useless-branch/eduSignalHW/board/board.kicad_pcb

## KiCad design board/board.kicad_pcb (2022-07-18)

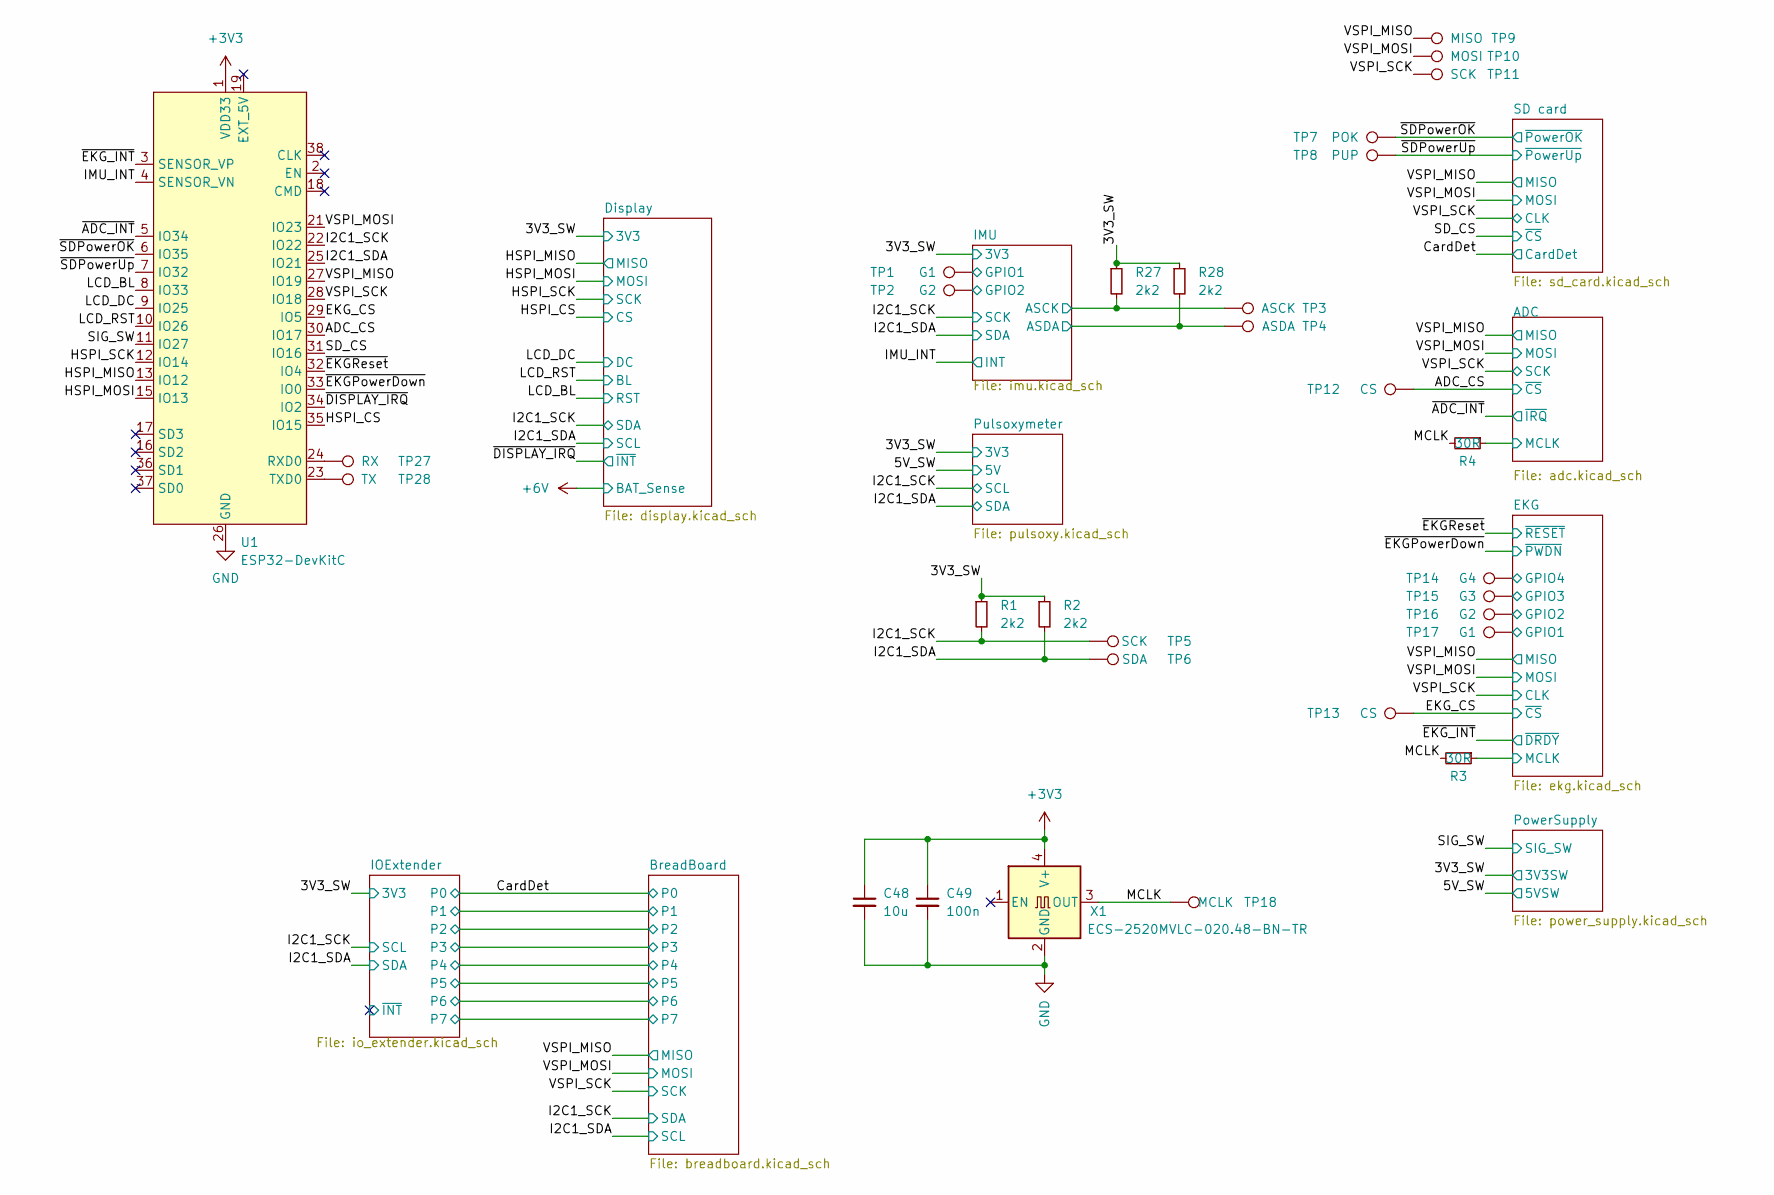
[picture p1: schematic board.kicad_sch, eduSignal]

Parts:
C48: 10u; C_0603_1608Metric
C49: 100n; C_0402_1005Metric
R1, R2, R27, R28: 2k2; R_0402_1005Metric
R3, R4: 30R; R_0402_1005Metric
TP1, TP17: G1; TestPoint_Pad_D1.0mm
TP2, TP16: G2; TestPoint_Pad_D1.0mm
TP3: ASCK; TestPoint_Pad_D1.0mm
TP4: ASDA; TestPoint_Pad_D1.0mm
TP5, TP11: SCK; TestPoint_Pad_D1.0mm
TP6: SDA; TestPoint_Pad_D1.0mm
TP7: POK; TestPoint_Pad_D1.0mm
TP8: PUP; TestPoint_Pad_D1.0mm
TP9: MISO; TestPoint_Pad_D1.0mm
TP10: MOSI; TestPoint_Pad_D1.0mm
TP12, TP13: CS; TestPoint_Pad_D1.0mm
TP14: G4; TestPoint_Pad_D1.0mm
TP15: G3; TestPoint_Pad_D1.0mm
TP18: MCLK; TestPoint_Pad_D1.0mm
TP27: RX; TestPoint_Pad_D1.0mm
TP28: TX; TestPoint_Pad_D1.0mm
U1: ESP32-DevKitC
X1: ECS-2520MVLC-020.48-BN-TR; Oscillator_SMD_EuroQuartz_XO32-4Pin_3.2x2.5mm

Connections:
+3V3: C48.1, C49.1, U1.1 (VDD33), X1.4 (V+); also elsewhere on the board
/3V3_SW: R1.1, R2.1, R27.1, R28.1; also elsewhere on the board
/ADC/MCLK: R4.1; also elsewhere on the board
/ADC_CS: TP12.1, U1.30 (IO17); also elsewhere on the board
/EKG/GPIO1: TP17.1; also elsewhere on the board
/EKG/GPIO2: TP16.1; also elsewhere on the board
/EKG/GPIO3: TP15.1; also elsewhere on the board
/EKG/GPIO4: TP14.1; also elsewhere on the board
/EKG/MCLK: R3.1; also elsewhere on the board
/EKG_CS: TP13.1, U1.29 (IO5); also elsewhere on the board
/HSPI_CS: U1.35 (IO15); also elsewhere on the board
/HSPI_MISO: U1.13 (IO12); also elsewhere on the board
/HSPI_MOSI: U1.15 (IO13); also elsewhere on the board
/HSPI_SCK: U1.12 (IO14); also elsewhere on the board
/I2C1_SCK: R1.2, TP5.1, U1.22 (IO22); also elsewhere on the board
/I2C1_SDA: R2.2, TP6.1, U1.25 (IO21); also elsewhere on the board
/IMU/ASCK: R27.2, TP3.1; also elsewhere on the board
/IMU/ASDA: R28.2, TP4.1; also elsewhere on the board
/IMU/GPIO1: TP1.1; also elsewhere on the board
/IMU/GPIO2: TP2.1; also elsewhere on the board
/IMU_INT: U1.4 (SENSOR_VN); also elsewhere on the board
/LCD_BL: U1.8 (IO33); also elsewhere on the board
/LCD_DC: U1.9 (IO25); also elsewhere on the board
/LCD_RST: U1.10 (IO26); also elsewhere on the board
/MCLK: R3.2, R4.2, TP18.1, X1.3 (OUT)
/SD_CS: U1.31 (IO16); also elsewhere on the board
/SIG_SW: U1.11 (IO27); also elsewhere on the board
/VSPI_MISO: TP9.1, U1.27 (IO19); also elsewhere on the board
/VSPI_MOSI: TP10.1, U1.21 (IO23); also elsewhere on the board
/VSPI_SCK: TP11.1, U1.28 (IO18); also elsewhere on the board
/~ADC_INT: U1.5 (IO34); also elsewhere on the board
/~DISPLAY_IRQ: U1.34 (IO2); also elsewhere on the board
/~EKGPowerDown: U1.33 (IO0); also elsewhere on the board
/~EKGReset: U1.32 (IO4); also elsewhere on the board
/~EKG_INT: U1.3 (SENSOR_VP); also elsewhere on the board
/~SDPowerOK: TP7.1, U1.6 (IO35); also elsewhere on the board
/~SDPowerUp: TP8.1, U1.7 (IO32); also elsewhere on the board
unnamed: TP27.1, U1.24 (RXD0)
unnamed: TP28.1, U1.23 (TXD0)

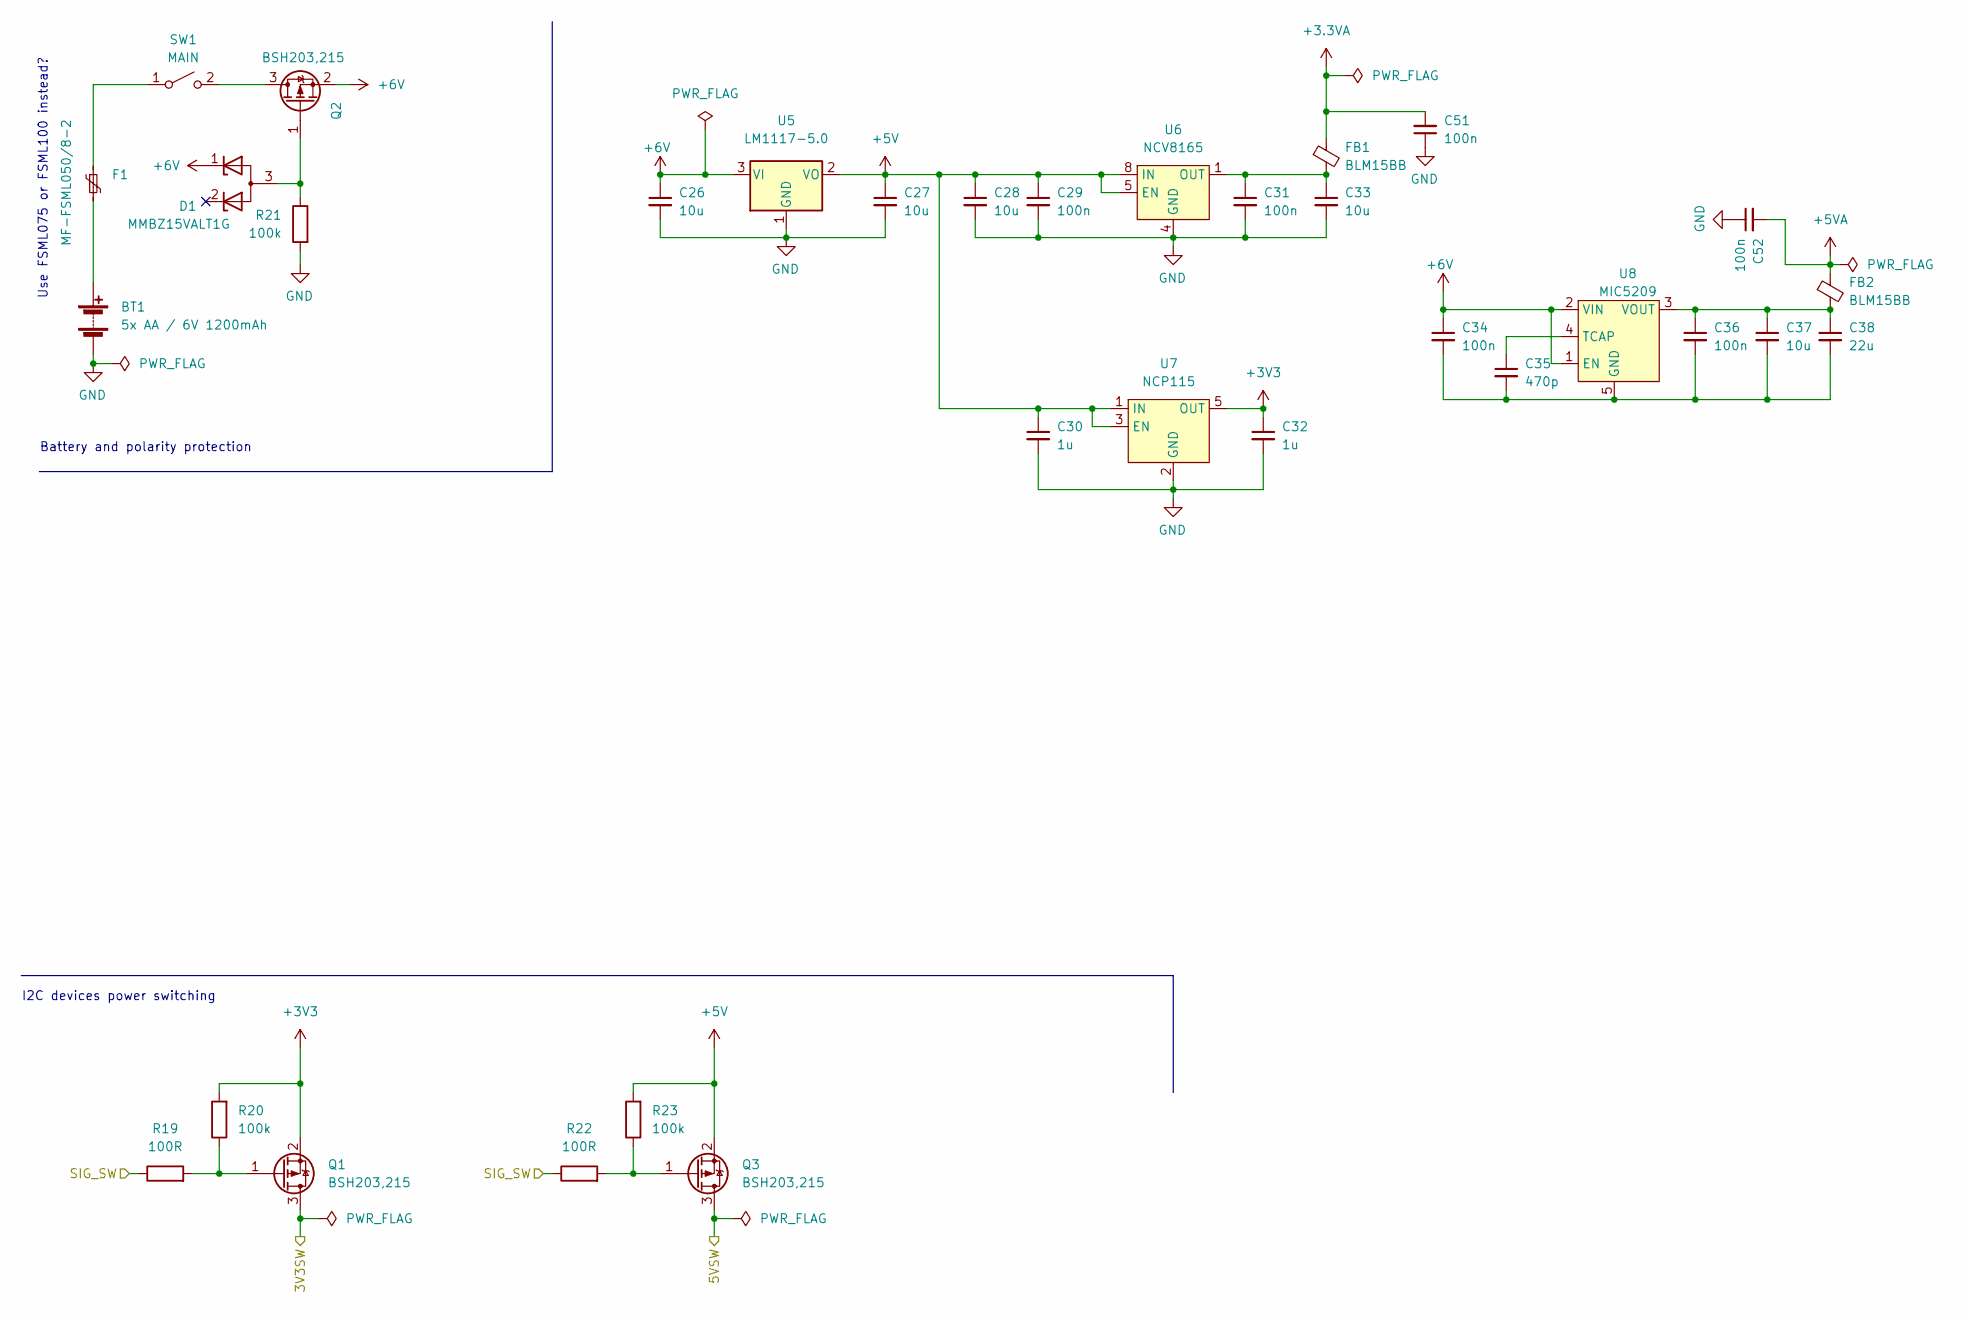
[picture p2: schematic power_supply.kicad_sch, eduSignal]

Parts:
BT1: 5x AA / 6V 1200mAh; PinHeader_1x02_P2.54mm_Vertical
C26, C27, C28, C33, C37: 10u; C_0603_1608Metric
C29, C31, C34, C36, C51, C52: 100n; C_0402_1005Metric
C30, C32: 1u; C_0603_1608Metric
C35: 470p; C_0402_1005Metric
C38: 22u; C_0805_2012Metric
D1: MMBZ15VALT1G; SOT-23; MOUSER_NO 863-SZMMBZ15VALT1G
F1: MF-FSML050/8-2; MF-FSML
FB1, FB2: BLM15BB; C_0402_1005Metric
Q1, Q3: BSH203,215; SOT-23; MOUSER_NO 78-SI2337DS-T1-BE3
Q2: BSH203,215; SOT-23; MOUSER_NO 771-BSH203215
R19, R22: 100R; R_0402_1005Metric; MOUSER_NO DO NOT ORDER
R20, R21, R23: 100k; R_0402_1005Metric; MOUSER_NO DO NOT ORDER
SW1: MAIN; PinHeader_1x02_P2.54mm_Vertical
U5: LM1117-5.0; SOT-223
U6: NCV8165; DFN-8-1EP_3x3mm_P0.65mm_EP1.7x2.05mm
U7: NCP115; TSOT-23-5
U8: MIC5209; SOICN-8LD

Connections:
+3.3VA: C51.2, FB1.1; also elsewhere on the board
+3V3: C32.1, Q1.2 (S), R20.2, U7.5 (OUT); also elsewhere on the board
+5V: C27.1, C28.1, C29.1, C30.1, Q3.2 (S), R23.2, U5.2 (VO), U5.4 (VO), U6.5 (EN), U6.8 (IN), U7.1 (IN), U7.3 (EN); also elsewhere on the board
+5VA: C52.2, FB2.1; also elsewhere on the board
+6V: C26.1, C34.1, D1.1 (K), Q2.2 (S), U5.3 (VI), U8.1 (EN), U8.2 (VIN); also elsewhere on the board
/3V3_SW: Q1.3 (D); also elsewhere on the board
/5V_SW: Q3.3 (D); also elsewhere on the board
/SIG_SW: R19.1, R22.1; also elsewhere on the board
unnamed: BT1.1 (+), F1.2
unnamed: C31.1, C33.1, FB1.2, U6.1 (OUT)
unnamed: C35.1, U8.4 (TCAP)
unnamed: C36.1, C37.1, C38.1, FB2.2, U8.3 (VOUT)
unnamed: D1.3 (A), Q2.1 (G), R21.1
unnamed: F1.1, SW1.1 (A)
unnamed: Q1.1 (G), R19.2, R20.1
unnamed: Q2.3 (D), SW1.2 (B)
unnamed: Q3.1 (G), R22.2, R23.1

Notes on the sheet:
I2C devices power switching
Battery and polarity protection
Use FSML075 or FSML100 instead?

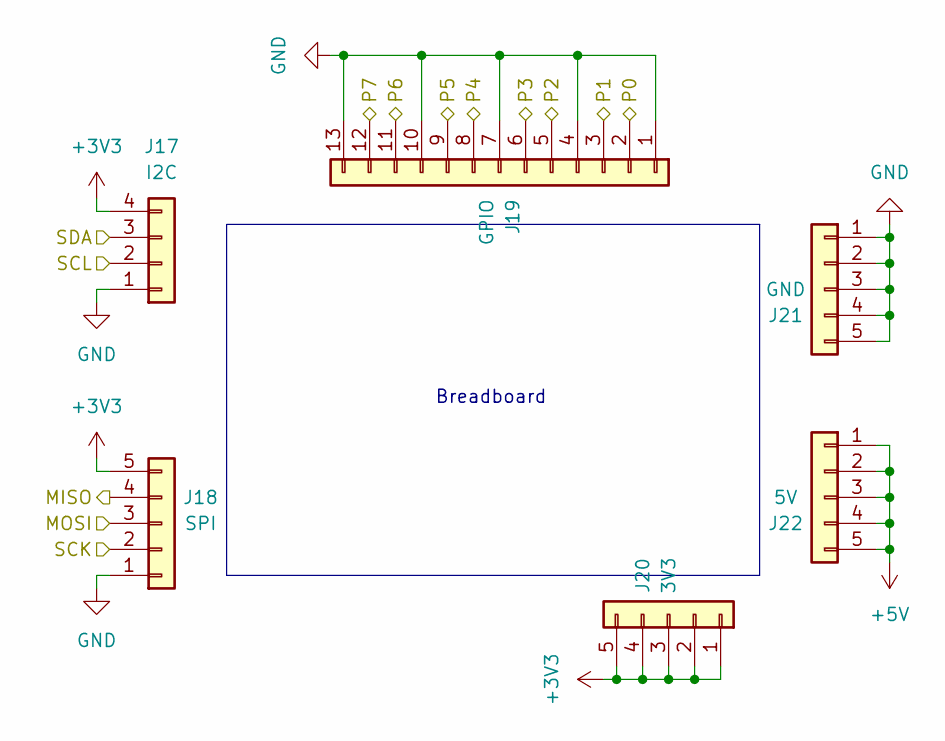
[picture p3: schematic breadboard.kicad_sch, eduSignal]

Parts:
J17: I2C; PinHeader_1x04_P2.54mm_Vertical
J18: SPI; PinHeader_1x05_P2.54mm_Vertical
J19: GPIO; PinHeader_1x13_P2.54mm_Vertical
J20: 3V3; PinHeader_1x05_P2.54mm_Vertical
J21: GND; PinHeader_1x05_P2.54mm_Vertical
J22: 5V; PinHeader_1x05_P2.54mm_Vertical

Connections:
+3V3: J17.4, J18.5, J20.1, J20.2, J20.3, J20.4, J20.5; also elsewhere on the board
+5V: J22.1, J22.2, J22.3, J22.4, J22.5; also elsewhere on the board
/BreadBoard/P1: J19.3; also elsewhere on the board
/BreadBoard/P2: J19.5; also elsewhere on the board
/BreadBoard/P3: J19.6; also elsewhere on the board
/BreadBoard/P4: J19.8; also elsewhere on the board
/BreadBoard/P5: J19.9; also elsewhere on the board
/BreadBoard/P6: J19.11; also elsewhere on the board
/BreadBoard/P7: J19.12; also elsewhere on the board
/CardDet: J19.2; also elsewhere on the board
/I2C1_SCK: J17.3; also elsewhere on the board
/I2C1_SDA: J17.2; also elsewhere on the board
/VSPI_MISO: J18.4; also elsewhere on the board
/VSPI_MOSI: J18.3; also elsewhere on the board
/VSPI_SCK: J18.2; also elsewhere on the board

Notes on the sheet:
Breadboard

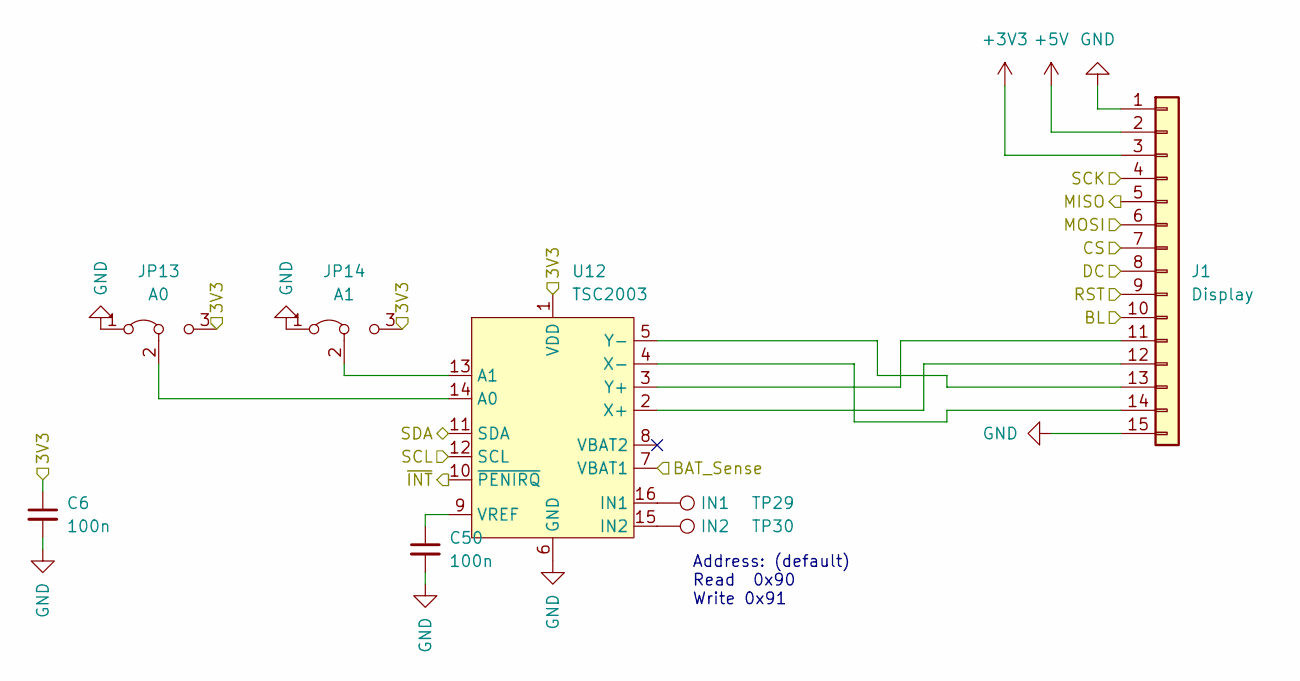
[picture p4: schematic display.kicad_sch, eduSignal]

Parts:
C6, C50: 100n; C_0402_1005Metric
J1: Display; PinHeader_1x15_P2.54mm_Vertical
JP13: A0; SolderJumper-3_P1.3mm_Bridged12_Pad1.0x1.5mm
JP14: A1; SolderJumper-3_P1.3mm_Bridged12_Pad1.0x1.5mm
TP29: IN1; TestPoint_Pad_D1.0mm
TP30: IN2; TestPoint_Pad_D1.0mm
U12: TSC2003; TSSOP-16_4.4x5mm_P0.65mm_EP3x3mm

Connections:
+3V3: J1.3; also elsewhere on the board
+5V: J1.2; also elsewhere on the board
+6V: U12.7 (VBAT1); also elsewhere on the board
/3V3_SW: C6.1, JP13.3 (B), JP14.3 (B), U12.1 (VDD); also elsewhere on the board
/HSPI_CS: J1.7; also elsewhere on the board
/HSPI_MISO: J1.5; also elsewhere on the board
/HSPI_MOSI: J1.6; also elsewhere on the board
/HSPI_SCK: J1.4; also elsewhere on the board
/I2C1_SCK: U12.11 (SDA); also elsewhere on the board
/I2C1_SDA: U12.12 (SCL); also elsewhere on the board
/LCD_BL: J1.9; also elsewhere on the board
/LCD_DC: J1.8; also elsewhere on the board
/LCD_RST: J1.10; also elsewhere on the board
/~DISPLAY_IRQ: U12.10 (~PENIRQ); also elsewhere on the board
unnamed: C50.1, U12.9 (VREF)
unnamed: J1.11, U12.3 (Y+)
unnamed: J1.12, U12.2 (X+)
unnamed: J1.13, U12.5 (Y-)
unnamed: J1.14, U12.4 (X-)
unnamed: JP13.2 (C), U12.14 (A0)
unnamed: JP14.2 (C), U12.13 (A1)
unnamed: TP29.1, U12.16 (IN1)
unnamed: TP30.1, U12.15 (IN2)

Notes on the sheet:
Address: (default) Read 0x90 Write 0x91

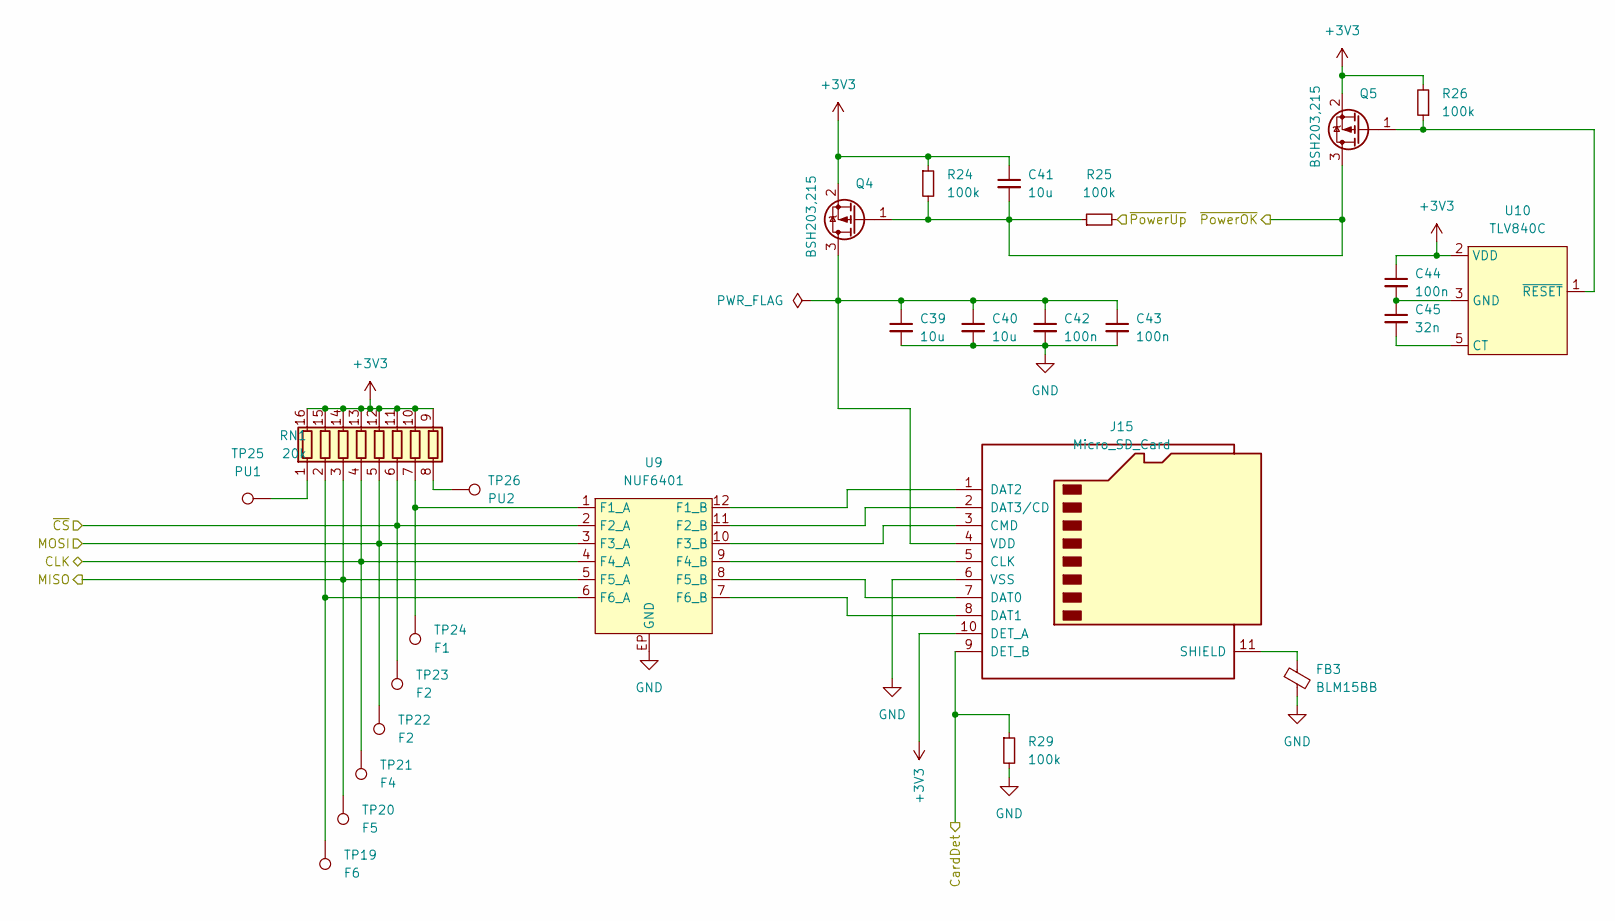
[picture p5: schematic sd_card.kicad_sch, eduSignal]

Parts:
C39, C40, C41: 10u; C_0603_1608Metric
C42, C43, C44: 100n; C_0402_1005Metric
C45: 32n; C_0402_1005Metric
FB3: BLM15BB; C_0402_1005Metric
J15: Micro_SD_Card; GCT MEM2061
Q4, Q5: BSH203,215; SOT-23; MOUSER_NO 771-BSH203215
R24, R25, R26, R29: 100k; R_0402_1005Metric
RN1: 20k; R_Array_Convex_8x0602
TP19: F6; TestPoint_Pad_D1.0mm
TP20: F5; TestPoint_Pad_D1.0mm
TP21: F4; TestPoint_Pad_D1.0mm
TP22, TP23: F2; TestPoint_Pad_D1.0mm
TP24: F1; TestPoint_Pad_D1.0mm
TP25: PU1; TestPoint_Pad_D1.0mm
TP26: PU2; TestPoint_Pad_D1.0mm
U9: NUF6401
U10: TLV840C; SOT-23-5

Connections:
+3V3: C41.1, C44.1, J15.10 (DET_A), Q4.2 (S), Q5.2 (S), R24.1, R26.2, RN1.9 (R8.2), RN1.10 (R7.2), RN1.11 (R6.2), RN1.12 (R5.2), RN1.13 (R4.2), RN1.14 (R3.2), RN1.15 (R2.2), RN1.16 (R1.2), U10.2 (VDD); also elsewhere on the board
/CardDet: J15.9 (DET_B), R29.1; also elsewhere on the board
/SD_CS: RN1.6 (R6.1), TP23.1, U9.2 (F2_A); also elsewhere on the board
/VSPI_MISO: RN1.3 (R3.1), TP20.1, U9.5 (F5_A); also elsewhere on the board
/VSPI_MOSI: RN1.5 (R5.1), TP22.1, U9.3 (F3_A); also elsewhere on the board
/VSPI_SCK: RN1.4 (R4.1), TP21.1, U9.4 (F4_A); also elsewhere on the board
/~SDPowerOK: C41.2, Q4.1 (G), Q5.3 (D), R24.2, R25.1; also elsewhere on the board
/~SDPowerUp: R25.2; also elsewhere on the board
unnamed: C39.1, C40.1, C42.1, C43.1, J15.4 (VDD), Q4.3 (D)
unnamed: C44.2, C45.1, U10.3 (GND)
unnamed: C45.2, U10.5 (CT)
unnamed: FB3.1, J15.11 (SHIELD)
unnamed: J15.1 (DAT2), U9.12 (F1_B)
unnamed: J15.2 (DAT3/CD), U9.11 (F2_B)
unnamed: J15.3 (CMD), U9.10 (F3_B)
unnamed: J15.5 (CLK), U9.9 (F4_B)
unnamed: J15.7 (DAT0), U9.8 (F5_B)
unnamed: J15.8 (DAT1), U9.7 (F6_B)
unnamed: Q5.1 (G), R26.1, U10.1 (~RESET)
unnamed: RN1.1 (R1.1), TP25.1
unnamed: RN1.2 (R2.1), TP19.1, U9.6 (F6_A)
unnamed: RN1.7 (R7.1), TP24.1, U9.1 (F1_A)
unnamed: RN1.8 (R8.1), TP26.1

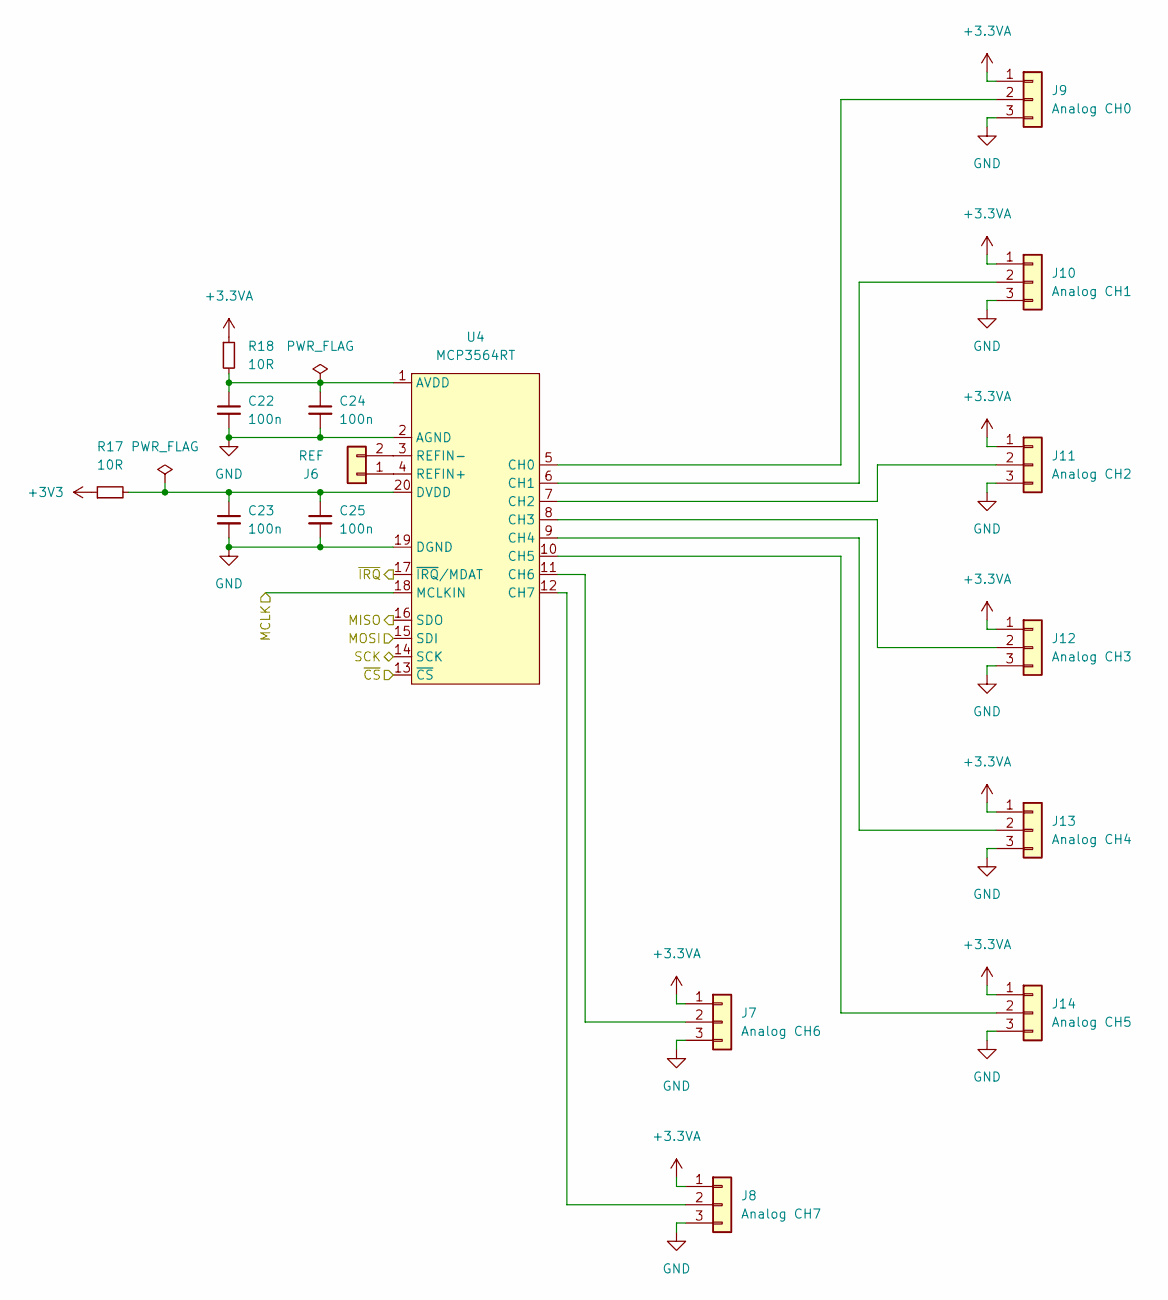
[picture p6: schematic adc.kicad_sch, eduSignal]

Parts:
C22, C23, C24, C25: 100n; C_0402_1005Metric
J6: REF; PinHeader_1x02_P2.54mm_Vertical
J7: Analog CH6; PinHeader_1x03_P2.54mm_Vertical
J8: Analog CH7; PinHeader_1x03_P2.54mm_Vertical
J9: Analog CH0; PinHeader_1x03_P2.54mm_Vertical
J10: Analog CH1; PinHeader_1x03_P2.54mm_Vertical
J11: Analog CH2; PinHeader_1x03_P2.54mm_Vertical
J12: Analog CH3; PinHeader_1x03_P2.54mm_Vertical
J13: Analog CH4; PinHeader_1x03_P2.54mm_Vertical
J14: Analog CH5; PinHeader_1x03_P2.54mm_Vertical
R17, R18: 10R; R_0402_1005Metric
U4: MCP3564RT; HTSSOP-20-1EP_4.4x6.5mm_P0.65mm_3.4x6.5mm_Mask2.75x3.43mm

Connections:
+3.3VA: J7.1, J8.1, J9.1, J10.1, J11.1, J12.1, J13.1, J14.1, R18.1; also elsewhere on the board
+3V3: R17.1; also elsewhere on the board
/ADC/MCLK: U4.18 (MCLKIN); also elsewhere on the board
/ADC_CS: U4.13 (~CS); also elsewhere on the board
/VSPI_MISO: U4.16 (SDO); also elsewhere on the board
/VSPI_MOSI: U4.15 (SDI); also elsewhere on the board
/VSPI_SCK: U4.14 (SCK); also elsewhere on the board
/~ADC_INT: U4.17 (~IRQ/MDAT); also elsewhere on the board
unnamed: C22.1, C24.1, R18.2, U4.1 (AVDD)
unnamed: C23.1, C25.1, R17.2, U4.20 (DVDD)
unnamed: J6.1, U4.4 (REFIN+)
unnamed: J6.2, U4.3 (REFIN-)
unnamed: J7.2, U4.11 (CH6)
unnamed: J8.2, U4.12 (CH7)
unnamed: J9.2, U4.5 (CH0)
unnamed: J10.2, U4.6 (CH1)
unnamed: J11.2, U4.7 (CH2)
unnamed: J12.2, U4.8 (CH3)
unnamed: J13.2, U4.9 (CH4)
unnamed: J14.2, U4.10 (CH5)

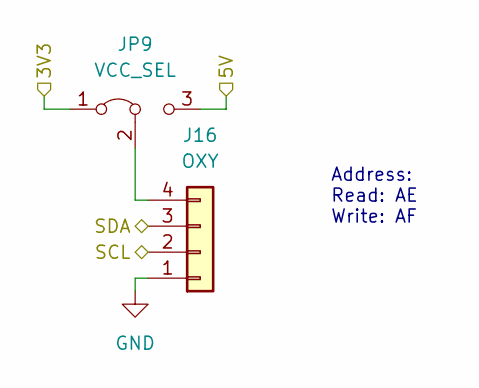
[picture p7: schematic pulsoxy.kicad_sch, eduSignal]

Parts:
J16: OXY; PinHeader_1x04_P2.54mm_Vertical
JP9: VCC_SEL; SolderJumper-3_P1.3mm_Bridged12_Pad1.0x1.5mm

Connections:
/3V3_SW: JP9.1 (A); also elsewhere on the board
/5V_SW: JP9.3 (B); also elsewhere on the board
/I2C1_SCK: J16.2; also elsewhere on the board
/I2C1_SDA: J16.3; also elsewhere on the board
unnamed: J16.4, JP9.2 (C)

Notes on the sheet:
Address: Read: AE Write: AF

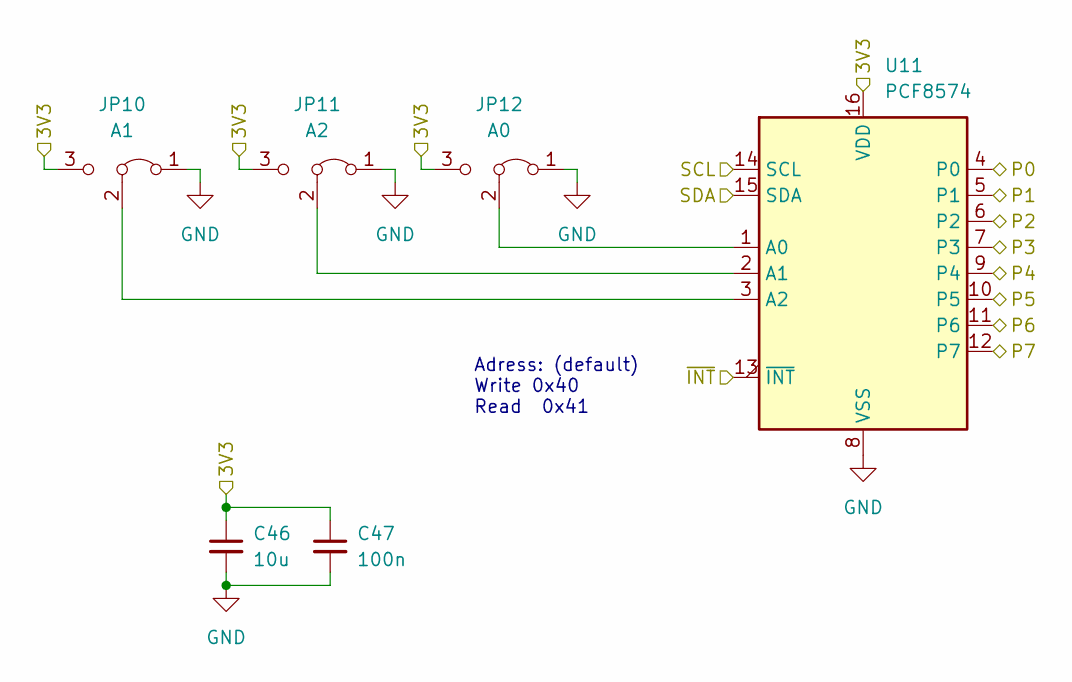
[picture p8: schematic io_extender.kicad_sch, eduSignal]

Parts:
C46: 10u; C_0603_1608Metric
C47: 100n; C_0402_1005Metric
JP10: A1; SolderJumper-3_P1.3mm_Bridged12_Pad1.0x1.5mm
JP11: A2; SolderJumper-3_P1.3mm_Bridged12_Pad1.0x1.5mm
JP12: A0; SolderJumper-3_P1.3mm_Bridged12_Pad1.0x1.5mm
U11: PCF8574; SOIC-16W_7.5x10.3mm_P1.27mm

Connections:
/3V3_SW: C46.1, C47.1, JP10.3 (B), JP11.3 (B), JP12.3 (B), U11.16 (VDD); also elsewhere on the board
/BreadBoard/P1: U11.5 (P1); also elsewhere on the board
/BreadBoard/P2: U11.6 (P2); also elsewhere on the board
/BreadBoard/P3: U11.7 (P3); also elsewhere on the board
/BreadBoard/P4: U11.9 (P4); also elsewhere on the board
/BreadBoard/P5: U11.10 (P5); also elsewhere on the board
/BreadBoard/P6: U11.11 (P6); also elsewhere on the board
/BreadBoard/P7: U11.12 (P7); also elsewhere on the board
/CardDet: U11.4 (P0); also elsewhere on the board
/I2C1_SCK: U11.14 (SCL); also elsewhere on the board
/I2C1_SDA: U11.15 (SDA); also elsewhere on the board
/IOExtender/~INT: U11.13 (~INT)
unnamed: JP10.2 (C), U11.3 (A2)
unnamed: JP11.2 (C), U11.2 (A1)
unnamed: JP12.2 (C), U11.1 (A0)

Notes on the sheet:
Adress: (default) Write 0x40 Read 0x41

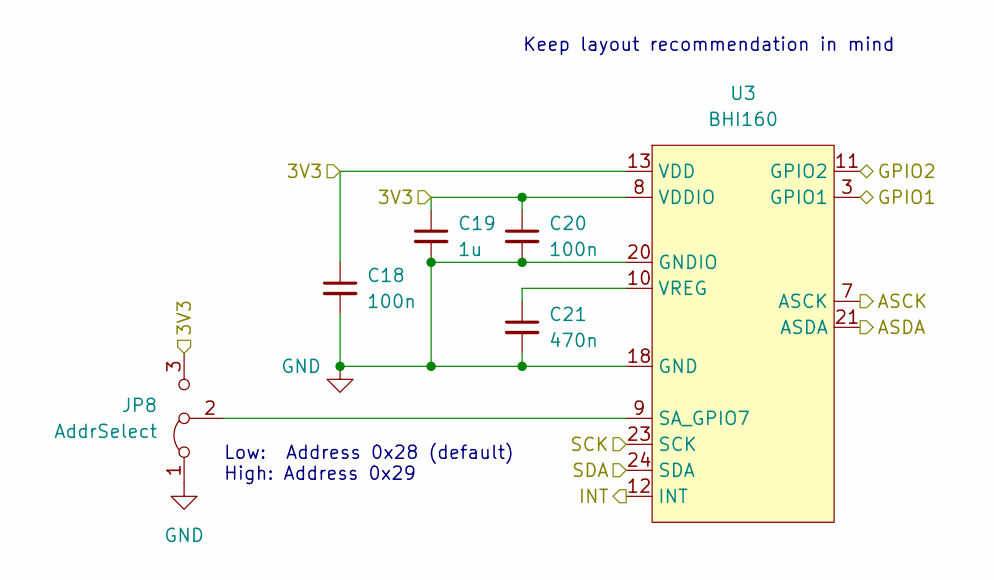
[picture p9: schematic imu.kicad_sch, eduSignal]

Parts:
C18, C20: 100n; C_0402_1005Metric
C19: 1u; C_0603_1608Metric
C21: 470n; C_0402_1005Metric
JP8: AddrSelect; SolderJumper-3_P1.3mm_Bridged12_Pad1.0x1.5mm
U3: BHI160

Connections:
/3V3_SW: C18.1, C19.1, C20.1, JP8.3 (B), U3.8 (VDDIO), U3.13 (VDD); also elsewhere on the board
/I2C1_SCK: U3.23 (SCK); also elsewhere on the board
/I2C1_SDA: U3.24 (SDA); also elsewhere on the board
/IMU/ASCK: U3.7 (ASCK); also elsewhere on the board
/IMU/ASDA: U3.21 (ASDA); also elsewhere on the board
/IMU/GPIO1: U3.3 (GPIO1); also elsewhere on the board
/IMU/GPIO2: U3.11 (GPIO2); also elsewhere on the board
/IMU_INT: U3.12 (INT); also elsewhere on the board
unnamed: C21.1, U3.10 (VREG)
unnamed: JP8.2 (C), U3.9 (SA_GPIO7)

Notes on the sheet:
Keep layout recommendation in mind
Low: Address 0x28 (default) High: Address 0x29

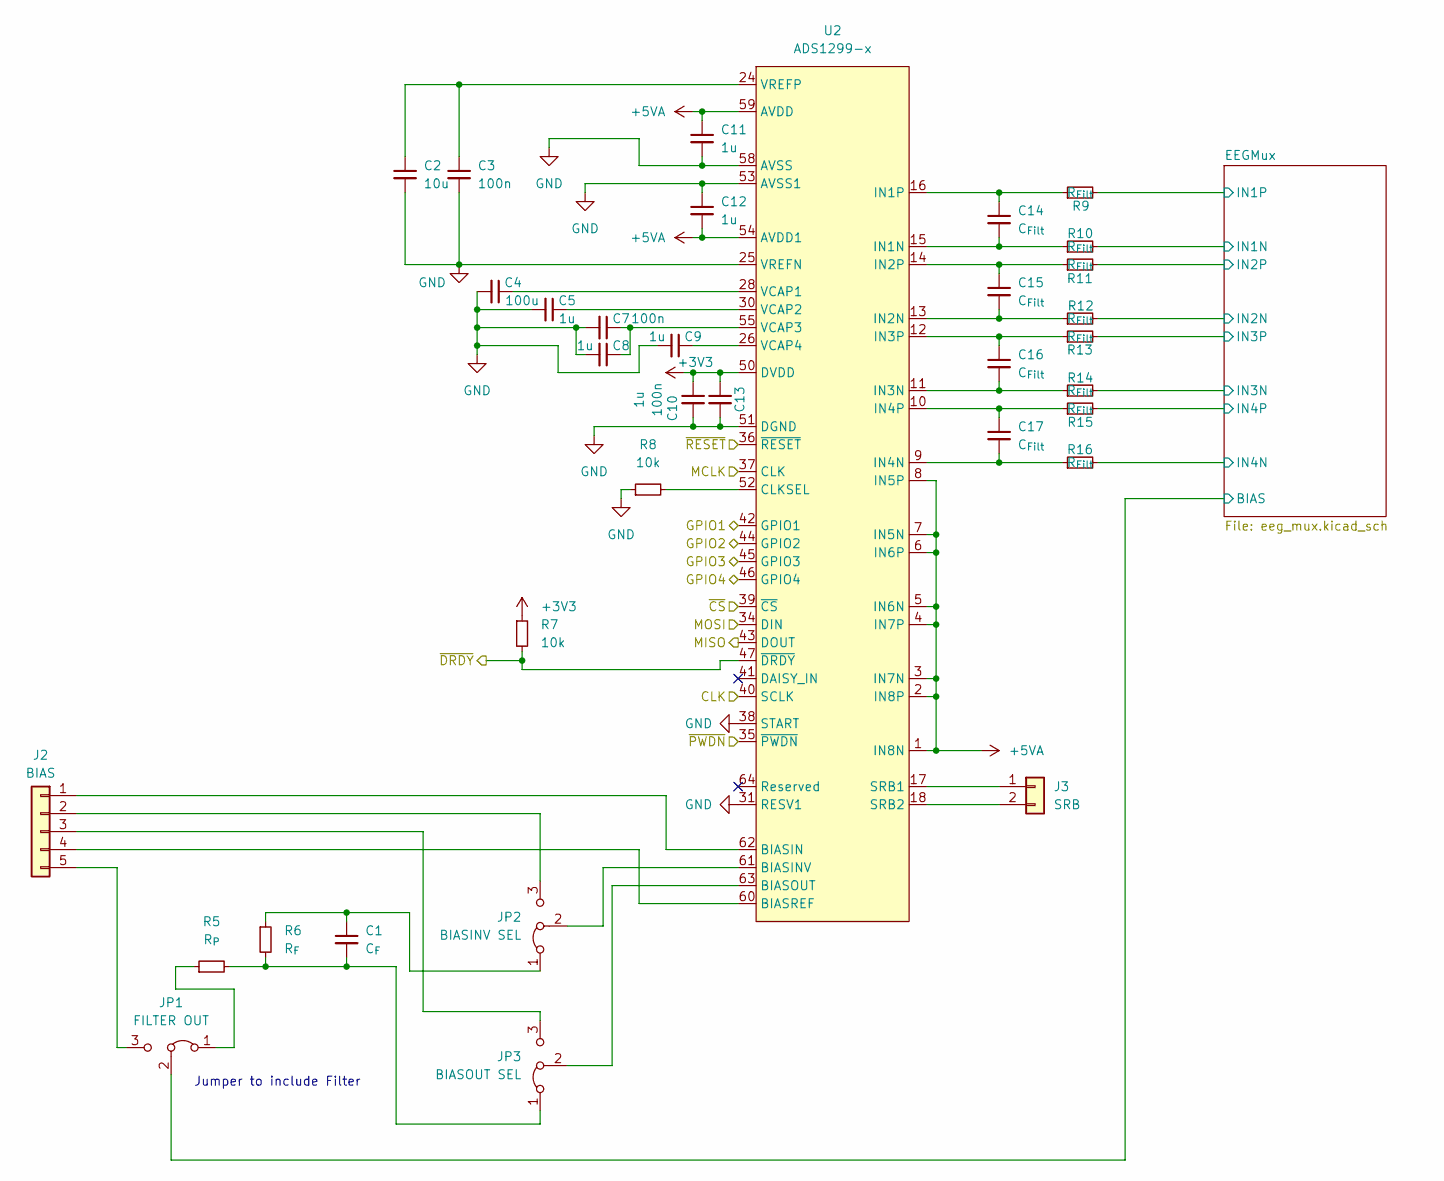
[picture p10: schematic ekg.kicad_sch, eduSignal]

Parts:
C1: C_{F}; C_0603_1608Metric_Pad1.08x0.95mm_HandSolder
C2: 10u; C_0603_1608Metric
C3, C7, C13: 100n; C_0402_1005Metric
C4: 100u; C_1206_3216Metric
C5, C8, C9, C10, C11, C12: 1u; C_0603_1608Metric
C14, C15, C16, C17: C_{Filt}; C_0603_1608Metric_Pad1.08x0.95mm_HandSolder
J2: BIAS; PinHeader_1x05_P2.54mm_Vertical
J3: SRB; PinHeader_1x02_P2.54mm_Vertical
JP1: FILTER OUT; PinHeader_1x03_P2.54mm_Vertical
JP2: BIASINV SEL; PinHeader_1x03_P2.54mm_Vertical
JP3: BIASOUT SEL; PinHeader_1x03_P2.54mm_Vertical
R5: R_{P}; R_0603_1608Metric_Pad0.98x0.95mm_HandSolder
R6: R_{F}; R_0603_1608Metric_Pad0.98x0.95mm_HandSolder
R7, R8: 10k; R_0402_1005Metric
R9, R10, R11, R12, R13, R14, R15, R16: R_{Filt}; R_0603_1608Metric_Pad0.98x0.95mm_HandSolder
U2: ADS1299-x; TQFP-64_10x10mm_P0.5mm

Connections:
+3V3: C10.1, C13.1, R7.1, U2.48 (DVDD), U2.50 (DVDD); also elsewhere on the board
+5VA: C11.1, C12.2, U2.1 (IN8N), U2.2 (IN8P), U2.3 (IN7N), U2.4 (IN7P), U2.5 (IN6N), U2.6 (IN6P), U2.7 (IN5N), U2.8 (IN5P), U2.19 (AVDD), U2.21 (AVDD), U2.22 (AVDD), U2.54 (AVDD1), U2.56 (AVDD), U2.59 (AVDD); also elsewhere on the board
/EKG/EEGMux/BIAS: JP1.2 (C); also elsewhere on the board
/EKG/EEGMux/IN1N: R10.2; also elsewhere on the board
/EKG/EEGMux/IN1P: R9.2; also elsewhere on the board
/EKG/EEGMux/IN2N: R12.2; also elsewhere on the board
/EKG/EEGMux/IN2P: R11.2; also elsewhere on the board
/EKG/EEGMux/IN3N: R14.2; also elsewhere on the board
/EKG/EEGMux/IN3P: R13.2; also elsewhere on the board
/EKG/EEGMux/IN4N: R16.2; also elsewhere on the board
/EKG/EEGMux/IN4P: R15.2; also elsewhere on the board
/EKG/GPIO1: U2.42 (GPIO1); also elsewhere on the board
/EKG/GPIO2: U2.44 (GPIO2); also elsewhere on the board
/EKG/GPIO3: U2.45 (GPIO3); also elsewhere on the board
/EKG/GPIO4: U2.46 (GPIO4); also elsewhere on the board
/EKG/MCLK: U2.37 (CLK); also elsewhere on the board
/EKG_CS: U2.39 (~CS); also elsewhere on the board
/VSPI_MISO: U2.43 (DOUT); also elsewhere on the board
/VSPI_MOSI: U2.34 (DIN); also elsewhere on the board
/VSPI_SCK: U2.40 (SCLK); also elsewhere on the board
/~EKGPowerDown: U2.35 (~PWDN); also elsewhere on the board
/~EKGReset: U2.36 (~RESET); also elsewhere on the board
/~EKG_INT: R7.2, U2.47 (~DRDY); also elsewhere on the board
unnamed: C1.1, JP2.1 (A), R6.1
unnamed: C1.2, JP3.1 (A), R5.2, R6.2
unnamed: C2.1, C3.1, U2.24 (VREFP)
unnamed: C4.1, U2.28 (VCAP1)
unnamed: C5.1, U2.30 (VCAP2)
unnamed: C7.1, C8.1, U2.55 (VCAP3)
unnamed: C9.1, U2.26 (VCAP4)
unnamed: C14.1, R9.1, U2.16 (IN1P)
unnamed: C14.2, R10.1, U2.15 (IN1N)
unnamed: C15.1, R11.1, U2.14 (IN2P)
unnamed: C15.2, R12.1, U2.13 (IN2N)
unnamed: C16.1, R13.1, U2.12 (IN3P)
unnamed: C16.2, R14.1, U2.11 (IN3N)
unnamed: C17.1, R15.1, U2.10 (IN4P)
unnamed: C17.2, R16.1, U2.9 (IN4N)
unnamed: J2.1, U2.62 (BIASIN)
unnamed: J2.2, JP2.3 (B)
unnamed: J2.3, JP3.3 (B)
unnamed: J2.4, U2.60 (BIASREF)
unnamed: J2.5, JP1.3 (B)
unnamed: J3.1, U2.17 (SRB1)
unnamed: J3.2, U2.18 (SRB2)
unnamed: JP1.1 (A), R5.1
unnamed: JP2.2 (C), U2.61 (BIASINV)
unnamed: JP3.2 (C), U2.63 (BIASOUT)
unnamed: R8.2, U2.52 (CLKSEL)

Notes on the sheet:
Jumper to include Filter
