useless-branch/eduSignalHW/board/board.kicad_pcb

## KiCad design board/board.kicad_pcb (continued)

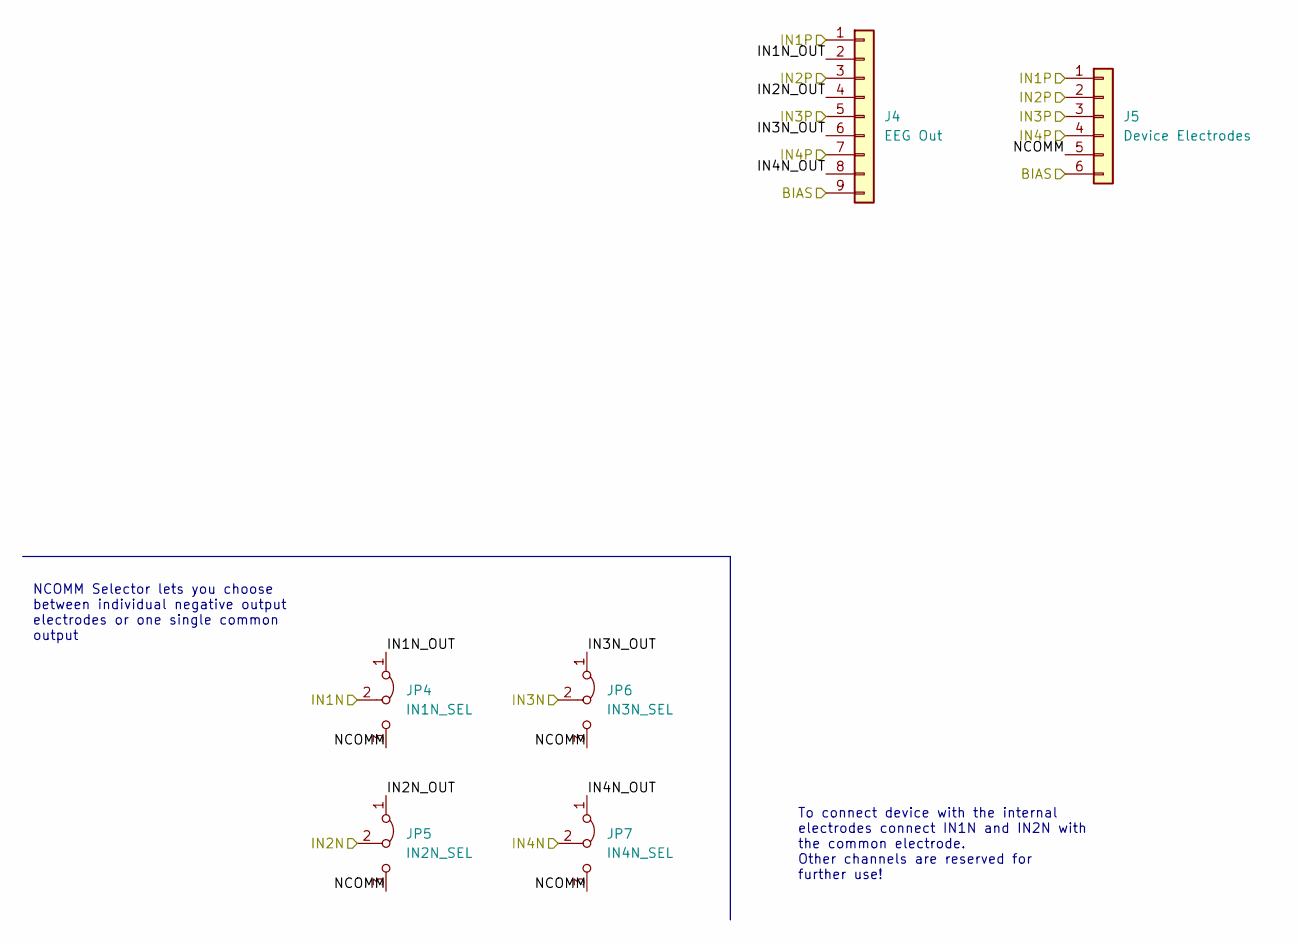
[picture p11: schematic eeg_mux.kicad_sch, eduSignal]

Parts:
J4: EEG Out; PinHeader_1x09_P2.54mm_Vertical
J5: Device Electrodes; PinHeader_1x06_P2.54mm_Vertical
JP4: IN1N_SEL; PinHeader_1x03_P2.54mm_Vertical
JP5: IN2N_SEL; PinHeader_1x03_P2.54mm_Vertical
JP6: IN3N_SEL; PinHeader_1x03_P2.54mm_Vertical
JP7: IN4N_SEL; PinHeader_1x03_P2.54mm_Vertical

Connections:
/EKG/EEGMux/BIAS: J4.9, J5.6; also elsewhere on the board
/EKG/EEGMux/IN1N: JP4.2 (C); also elsewhere on the board
/EKG/EEGMux/IN1N_OUT: J4.2, JP4.1 (A)
/EKG/EEGMux/IN1P: J4.1, J5.1; also elsewhere on the board
/EKG/EEGMux/IN2N: JP5.2 (C); also elsewhere on the board
/EKG/EEGMux/IN2N_OUT: J4.4, JP5.1 (A)
/EKG/EEGMux/IN2P: J4.3, J5.2; also elsewhere on the board
/EKG/EEGMux/IN3N: JP6.2 (C); also elsewhere on the board
/EKG/EEGMux/IN3N_OUT: J4.6, JP6.1 (A)
/EKG/EEGMux/IN3P: J4.5, J5.3; also elsewhere on the board
/EKG/EEGMux/IN4N: JP7.2 (C); also elsewhere on the board
/EKG/EEGMux/IN4N_OUT: J4.8, JP7.1 (A)
/EKG/EEGMux/IN4P: J4.7, J5.4; also elsewhere on the board
/EKG/EEGMux/NCOMM: J5.5, JP4.3 (B), JP5.3 (B), JP6.3 (B), JP7.3 (B)

Notes on the sheet:
NCOMM Selector lets you choose between individual negative output electrodes or one single common output
To connect device with the internal electrodes connect IN1N and IN2N with the common electrode. Other channels are reserved for further use!

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
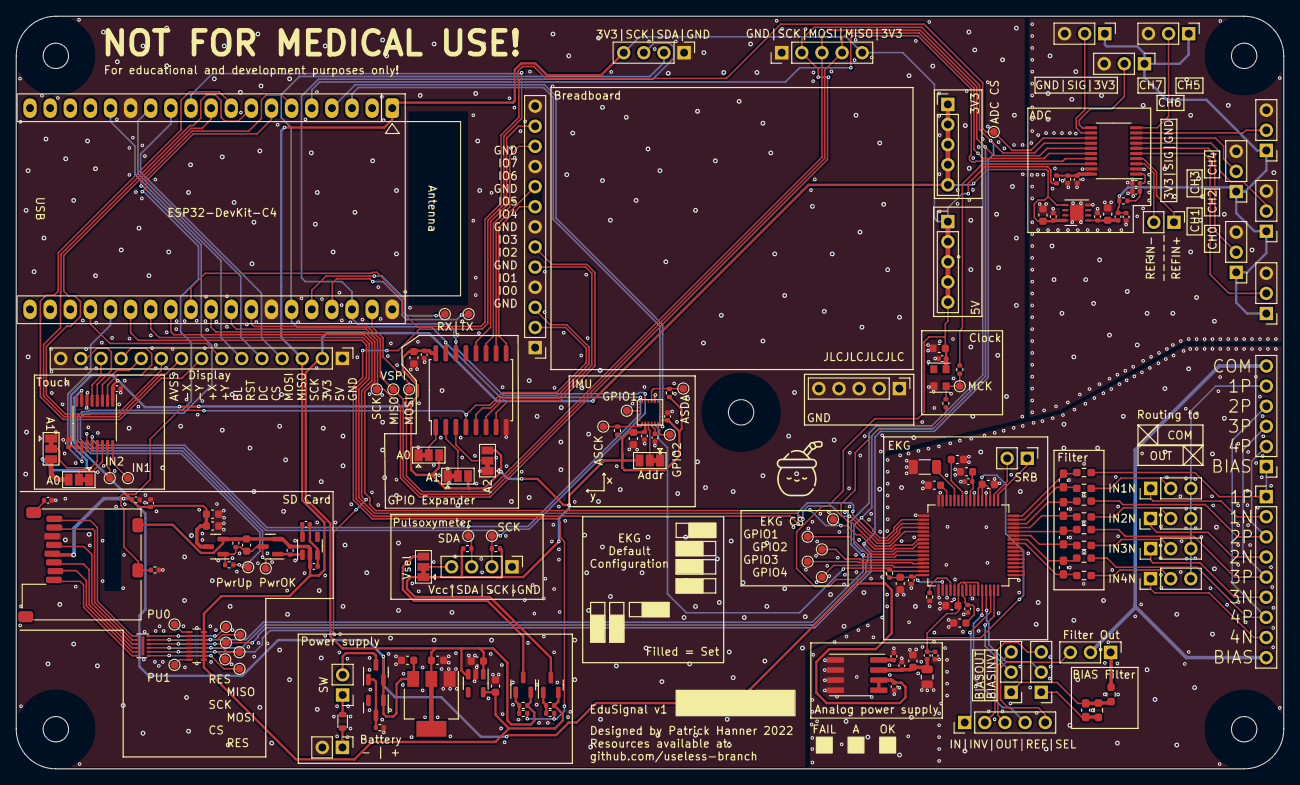
[picture p12: board board.kicad_pcb from above]

Board: 4 copper layers, 160.0 x 95.0 mm, 178 parts (0 on the bottom side), 144 nets.

Other parts of the board:
H1, H2, H3, H3#2, H5: MountingHole; MountingHole_3.2mm_M3_no_Mask
