useless-branch/eduSignalHW/(commit log)

2022-05-23 added ekg chip
    [board.kicad_sch, ekg.kicad_sch]
2022-05-30 added filter and imu
    [board.kicad_sch, eeg_mux.kicad_sch, ekg.kicad_sch, imu.kicad_sch]
2022-06-02 updated hw project
    [board.kicad_sch, eeg_mux.kicad_sch, ekg.kicad_sch, imu.kicad_sch]
2022-06-07 updated schematic
    [adc.kicad_sch, board.kicad_sch, eeg_mux.kicad_sch, ekg.kicad_sch, imu.kicad_sch, power_supply.kicad_sch]
2022-06-20 added SD card and pulsoxy
    [board.kicad_sch, pulsoxy.kicad_sch, sd_card.kicad_sch]
2022-06-22 updated schematic after review
    [board.kicad_sch, ekg.kicad_sch, power_supply.kicad_sch]
2022-06-23 added io expander
    [board.kicad_sch, io_extender.kicad_sch, pulsoxy.kicad_sch]
2022-06-23 updated after meeting
    [board.kicad_sch]
2022-06-25 ERC run
    [adc.kicad_sch, board.kicad_sch, breadboard.kicad_sch, eeg_mux.kicad_sch, ekg.kicad_sch, imu.kicad_sch, io_extender.kicad_sch, power_supply.kicad_sch]
2022-06-27 added fuse and capacitor to schematic
    [board.kicad_sch, power_supply.kicad_sch, sd_card.kicad_sch]
2022-06-27 added footprints to symbols and started layout
    [adc.kicad_sch, board.kicad_pcb, board.kicad_sch, breadboard.kicad_sch, eeg_mux.kicad_sch, ekg.kicad_sch, imu.kicad_sch, io_extender.kicad_sch]
2022-06-30 WIP pushed for meeting
    [adc.kicad_sch, board.kicad_pcb, board.kicad_sch, display.kicad_sch, eeg_mux.kicad_sch, ekg.kicad_sch, imu.kicad_sch, power_supply.kicad_sch]
2022-06-30 updated 3d models
    [board.kicad_pcb]
2022-07-07 redesigned board partially
    [board.kicad_pcb]
2022-07-08 finished layout for review
    [adc.kicad_sch, board.kicad_pcb, board.kicad_sch, ekg.kicad_sch, imu.kicad_sch, power_supply.kicad_sch, sd_card.kicad_sch]
2022-07-11 did some minor changes
    [board.kicad_pcb]
2022-07-13 worked feedback into layout
    [board.kicad_pcb, board.kicad_sch, imu.kicad_sch, sd_card.kicad_sch]
2022-07-14 did some minor stuff
    [adc.kicad_sch, board.kicad_pcb, board.kicad_sch, breadboard.kicad_sch, display.kicad_sch, eeg_mux.kicad_sch, ekg.kicad_sch, imu.kicad_sch]
2022-07-16 worked feedback into layout with dp
    [board.kicad_pcb, board.kicad_sch, ekg.kicad_sch, power_supply.kicad_sch]
2022-07-18 updated gerber data
    [board.kicad_pcb]
2022-09-07 fixed errors in schematic
    [adc.kicad_sch, board.kicad_sch, power_supply.kicad_sch, pulsoxy.kicad_sch, sd_card.kicad_sch]
2022-10-24 Updated board
    [board.kicad_sch, sd_card.kicad_sch]
